ssosik/button-mash/docs/digikey-order-2026-09-30.csv

Index | Quantity | Part Number | Manufacturer Part Number | Description | Unit of Measure | Customer Reference | Available | Backorder | Unit Price | Extended Price USD
1 | 5 | 296-4655-5-ND | SN74AHCT125N | IC BUFF 4.5V/5.5V 14-PDIP |  | whack a mole | 5 | 0 | 0.95000 | $4.75
2 | 5 | AE9989-ND | A 14-LC-TT | CONN IC DIP SOCKET 14POS TIN |  | whack a mole | 5 | 0 | 0.56000 | $2.80
3 | 10 | CF14JT330RCT-ND | CF14JT330R | RES 330 OHM 5% 1/4W AXIAL |  | whack a mole | 10 | 0 | 0.02700 | $0.27
4 | 5 | 399-6637-ND | ESY108M016AH4AA | CAP ALUM 1000UF 20% 16V RADIAL |  | whack a mole | 5 | 0 | 0.96000 | $4.80
5 | 10 | 732-8793-1-ND | 860020372006 | CAP ALUM 100UF 20% 16V RADIAL TH |  | whack a mole | 10 | 0 | 0.12000 | $1.20
6 | 10 | 399-C315C104K5R5TA-ND | C315C104K5R5TA | CAP CER 0.1UF 50V X7R RADIAL |  | whack a mole | 10 | 0 | 0.48800 | $4.88
7 | 10 | 2946-221-415-ND | 221-415 | SPLICE LEVER 24-12AWG 5POS |  | whack a mole | 10 | 0 | 0.99100 | $9.91
8 | 1 | 243-1577-ND | 10189 | CRIMPER MIN INSULATED TERMINALS |  |  | 1 | 0 | 68.33000 | $68.33
9 | 50 | A27804CT-ND | 2-520181-2 | CONN QC RCPT 18-22AWG 0.187 |  | whack a mole | 50 | 0 | 0.22780 | $11.39
10 | 20 | 455-2218-ND | XHP-6 | CONN RCPT HSG 6POS 2.50MM |  | whack a mole | 20 | 0 | 0.08400 | $1.68
11 | 20 | 455-B6B-XH-A-ND | B6B-XH-A | CONN HEADER VERT 6POS 2.5MM |  | whack a mole | 20 | 0 | 0.19900 | $3.98
12 | 20 | 455-2266-ND | XHP-2 | CONN RCPT HSG 2POS 2.50MM |  | whack a mole | 20 | 0 | 0.05900 | $1.18
13 | 20 | 455-B2B-XH-A-ND | B2B-XH-A | CONN HEADER VERT 2POS 2.5MM |  | whack a mole | 20 | 0 | 0.08700 | $1.74
