ssosik/button-mash/docs/digikey-additions.csv

Quantity | Part Number | Manufacturer Part Number | Description | Customer Reference
70 | 455-1135TR-ND | SXH-001T-P0.6 | CONN SOCKET 22-28AWG CRIMP TIN | whack a mole
