ssosik/button-mash/hardware/whack a mole start button hole bushing.stl

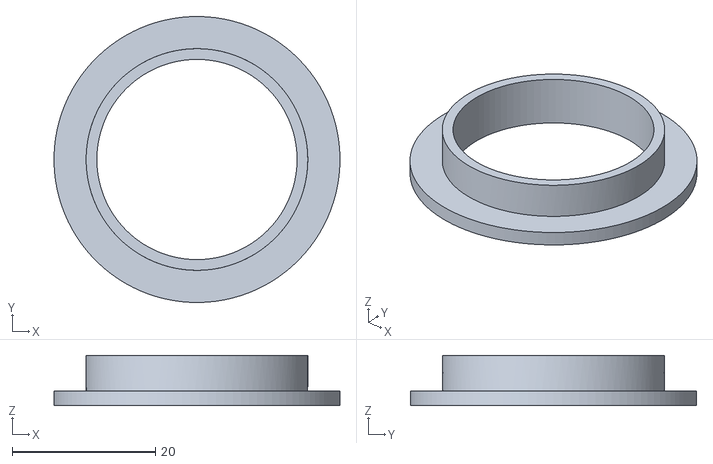
[picture p1: CAD file, 2026-10-30]
hardware/whack a mole start button hole bushing.stl
40.0 x 40.0 x 7.00
