ssosik/button-mash/hardware/whack a mole button hole bushing.stl

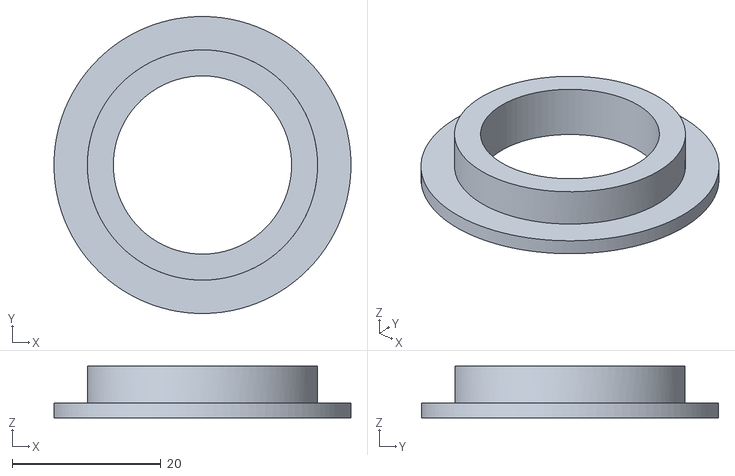
[picture p2: CAD file, 2026-10-30]
hardware/whack a mole button hole bushing.stl
40.0 x 40.0 x 7.00
