ssosik/button-mash/hardware/button-board/button-board.pdf

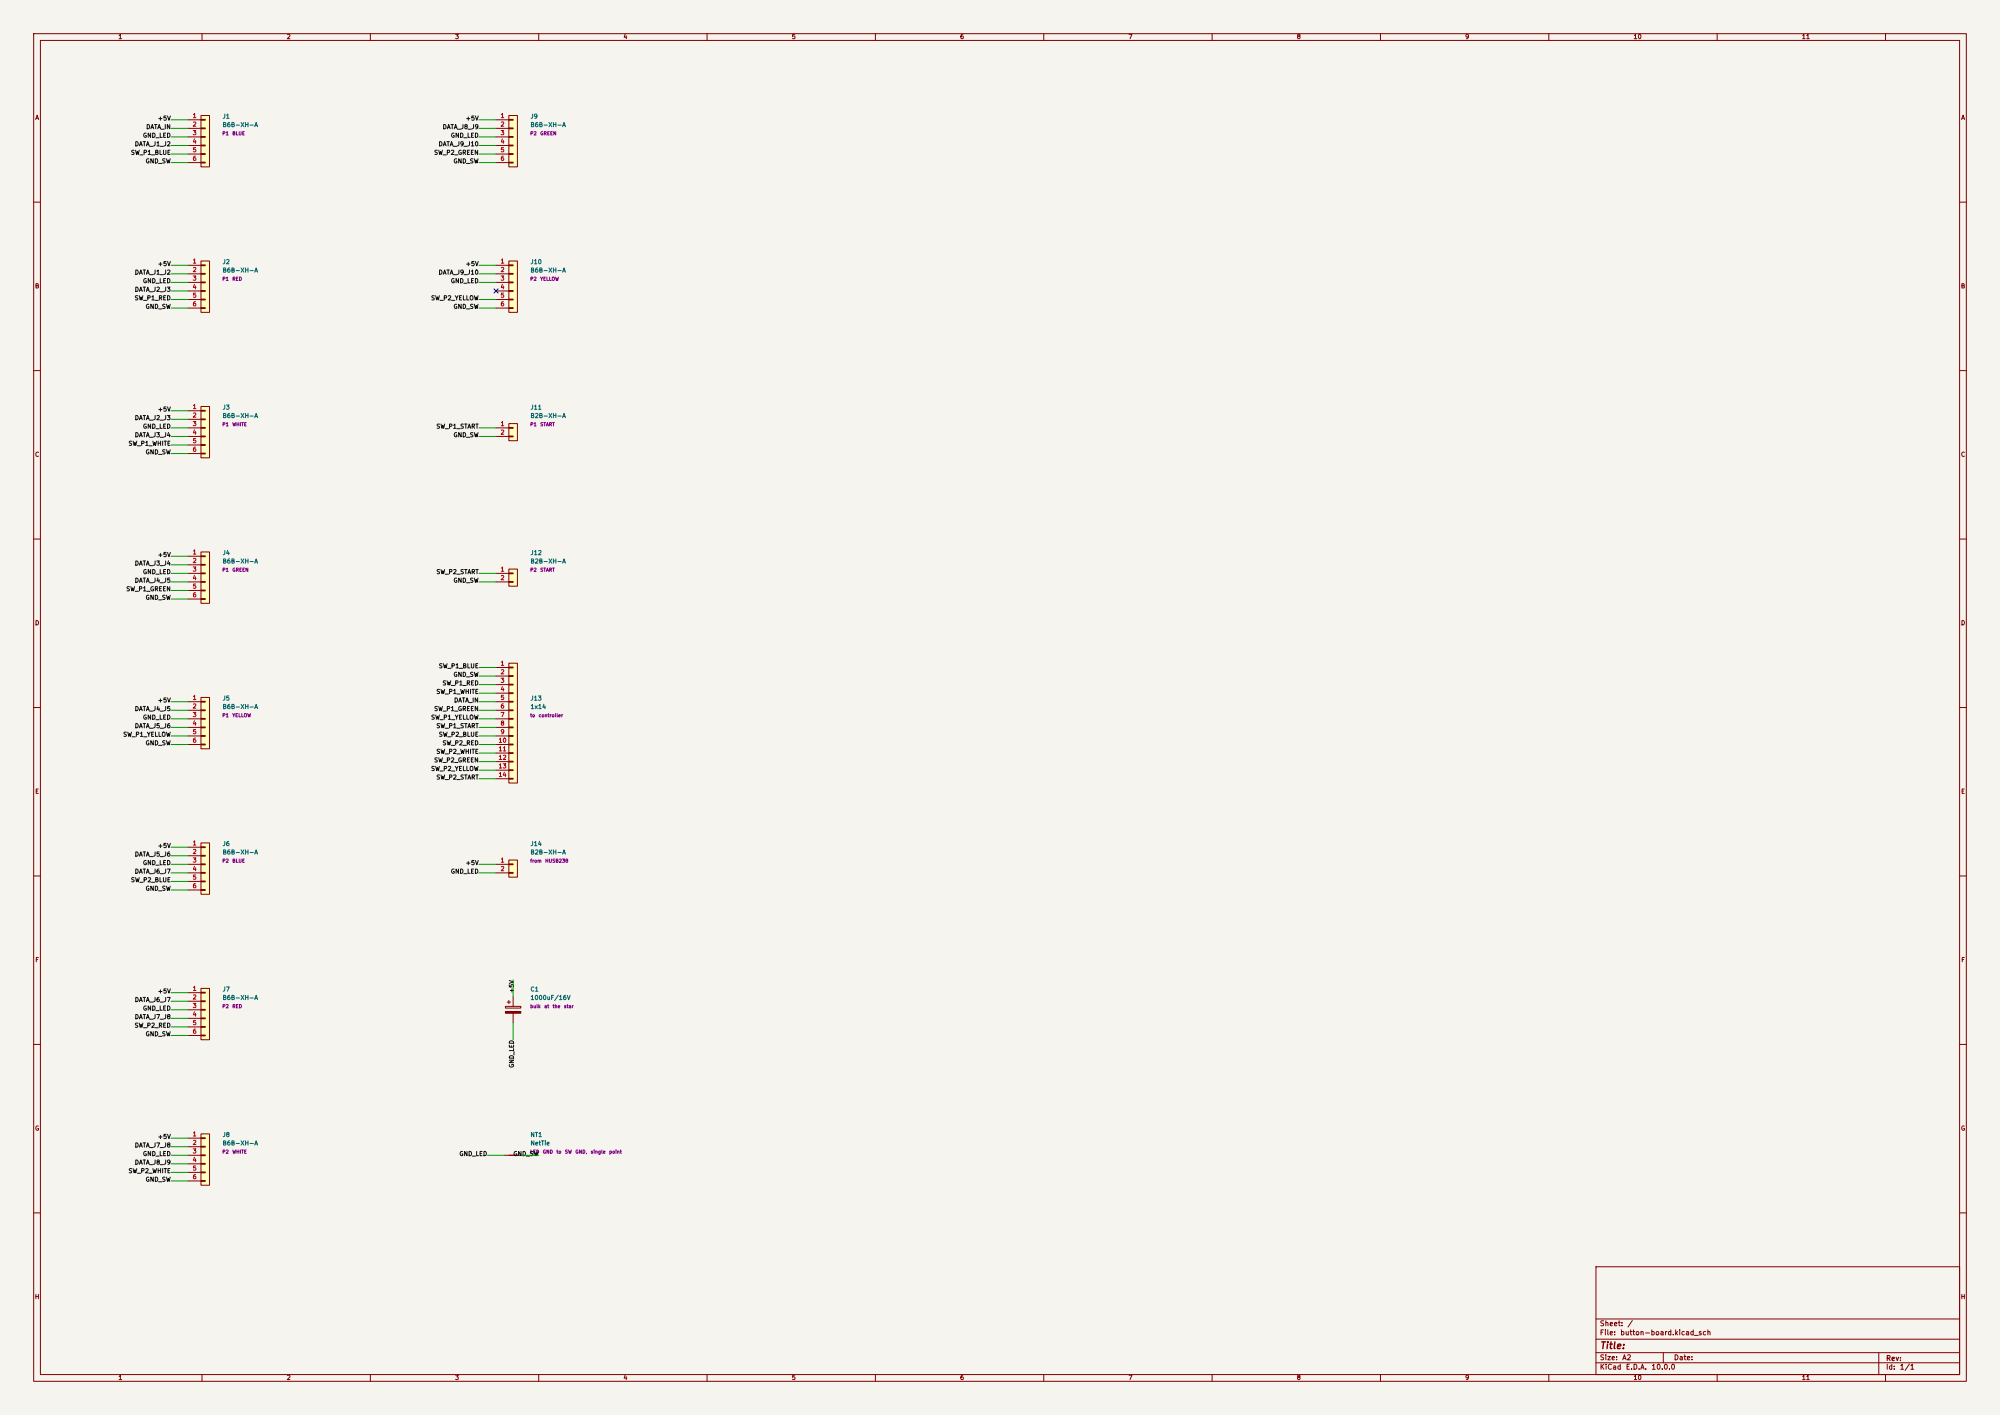
[picture p3: page 1]

LED GND to SW GND, single point 123456
P2 GREEN 12
SW_P2_GREEN

bulk at the star 123456
DATA_J3_J4 DATA_J5_J6 GND_LED

Size: A2 | Rev:
KiCad E.D.A. 10.0.0 | Id: 1/1
