ssosik/button-mash/hardware/controller-board/controller-board/controller-board.kicad_pcb

## KiCad design hardware/controller-board/controller-board/controller-board.kicad_pcb (2026-10-30)

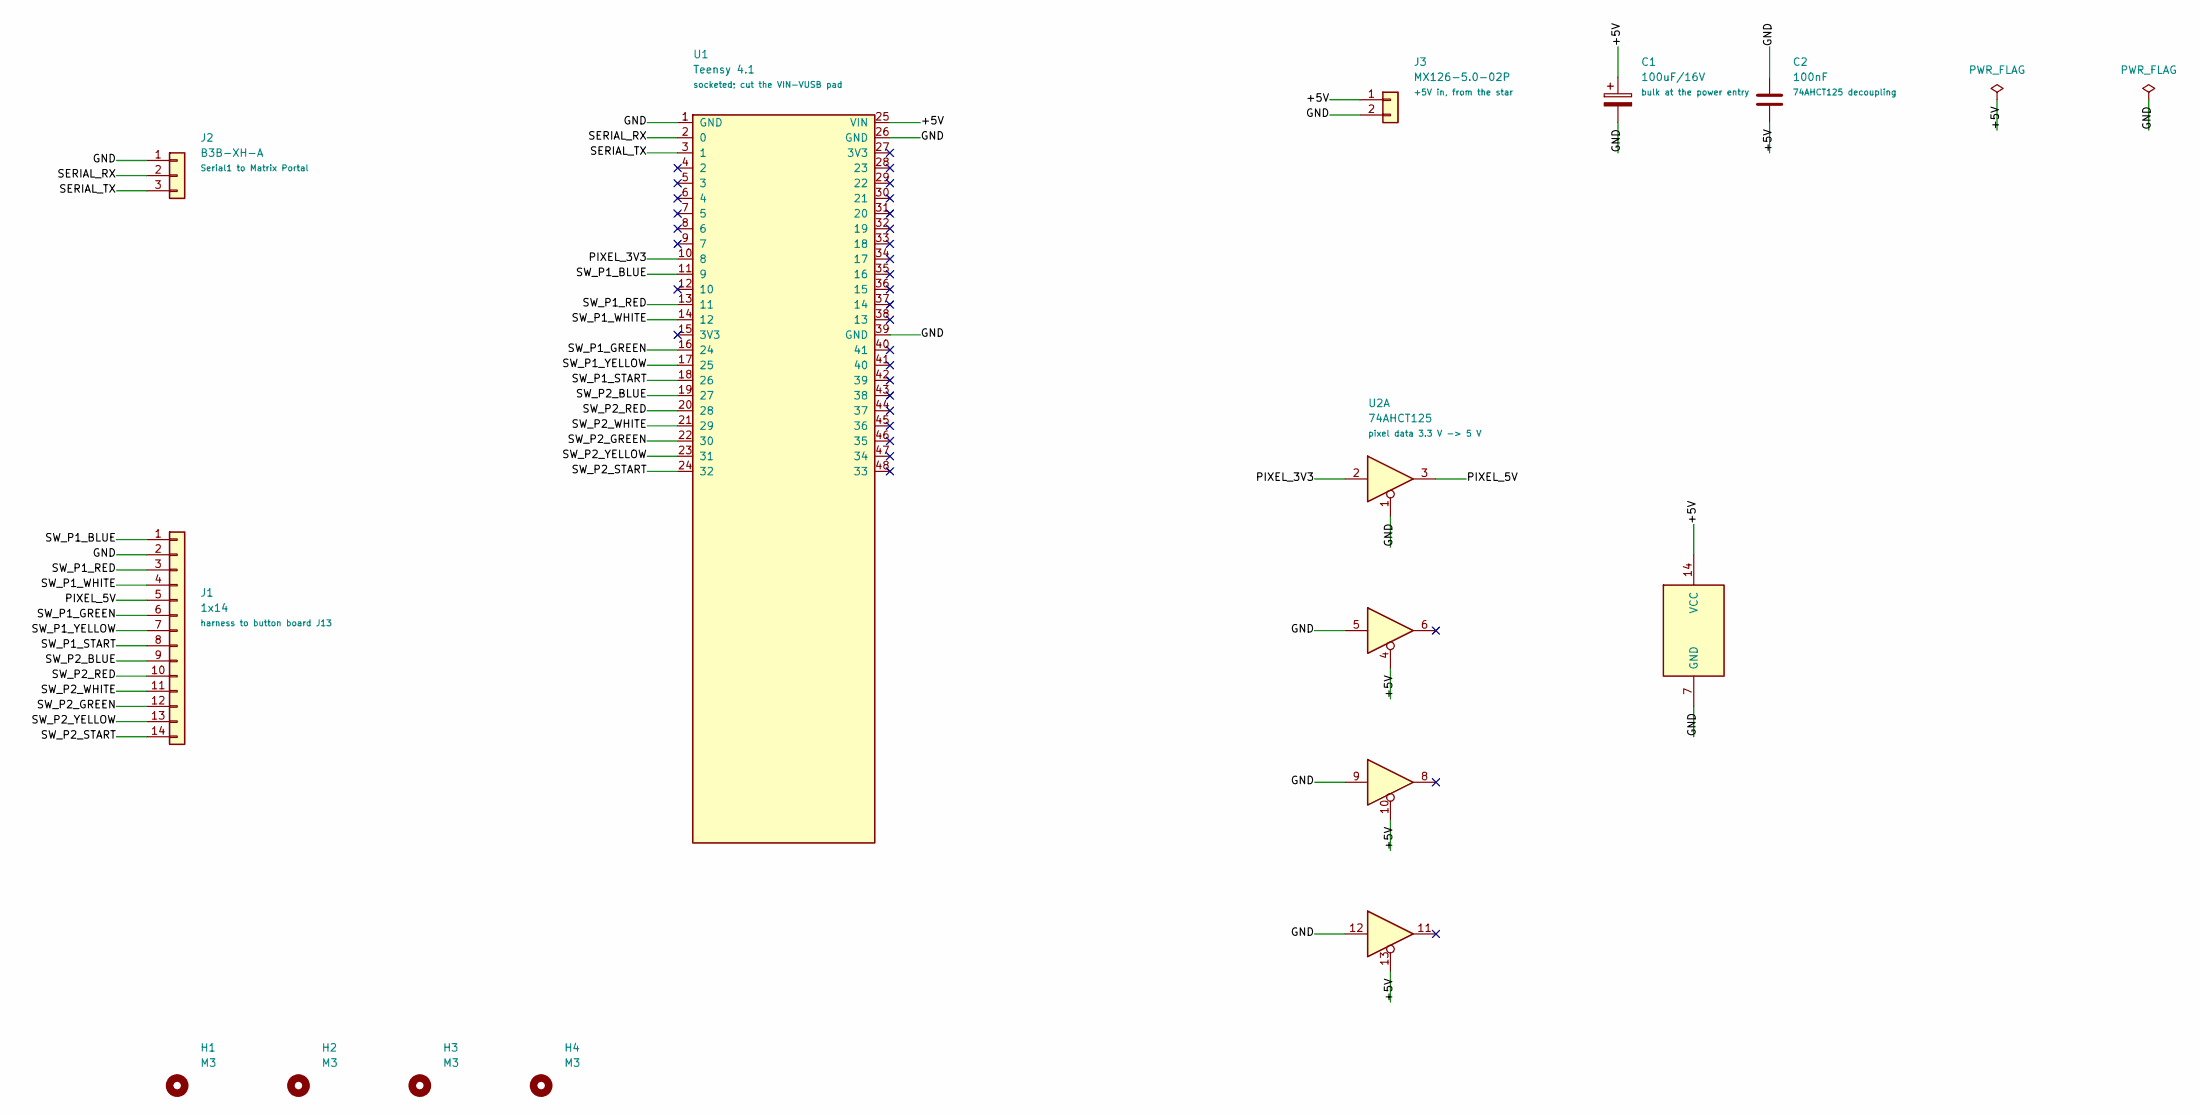
[picture p4: schematic controller-board.kicad_sch, Whack-A-Mole Attack - controller board]

Parts:
C1: 100uF/16V; CP_Radial_D6.3mm_P2.50mm
C2: 100nF; C_Disc_D5.0mm_W2.5mm_P5.00mm
H1, H2, H3, H4: M3; MountingHole_3.2mm_M3
J1: 1x14; PinHeader_1x14_P2.54mm_Vertical
J2: B3B-XH-A; JST_XH_B3B-XH-A_1x03_P2.50mm_Vertical
J3: MX126-5.0-02P; TerminalBlock_MaiXu_MX126-5.0-02P_1x02_P5.00mm
U1: Teensy 4.1; Teensy41_Socketed
U2: 74AHCT125; DIP-14_W7.62mm_Socket

Connections:
/+5V: C1.1, C2.2, J3.1, U1.25 (VIN), U2.4, U2.10, U2.13, U2.14 (VCC)
/GND: C1.2, C2.1, J1.2, J2.1, J3.2, U1.1 (GND), U1.26 (GND), U1.39 (GND), U2.1, U2.5, U2.7 (GND), U2.9, U2.12
/PIXEL_3V3: U1.10 (8), U2.2
/PIXEL_5V: J1.5, U2.3
/SERIAL_RX: J2.2, U1.2 (0)
/SERIAL_TX: J2.3, U1.3 (1)
/SW_P1_BLUE: J1.1, U1.11 (9)
/SW_P1_GREEN: J1.6, U1.16 (24)
/SW_P1_RED: J1.3, U1.13 (11)
/SW_P1_START: J1.8, U1.18 (26)
/SW_P1_WHITE: J1.4, U1.14 (12)
/SW_P1_YELLOW: J1.7, U1.17 (25)
/SW_P2_BLUE: J1.9, U1.19 (27)
/SW_P2_GREEN: J1.12, U1.22 (30)
/SW_P2_RED: J1.10, U1.20 (28)
/SW_P2_START: J1.14, U1.24 (32)
/SW_P2_WHITE: J1.11, U1.21 (29)
/SW_P2_YELLOW: J1.13, U1.23 (31)

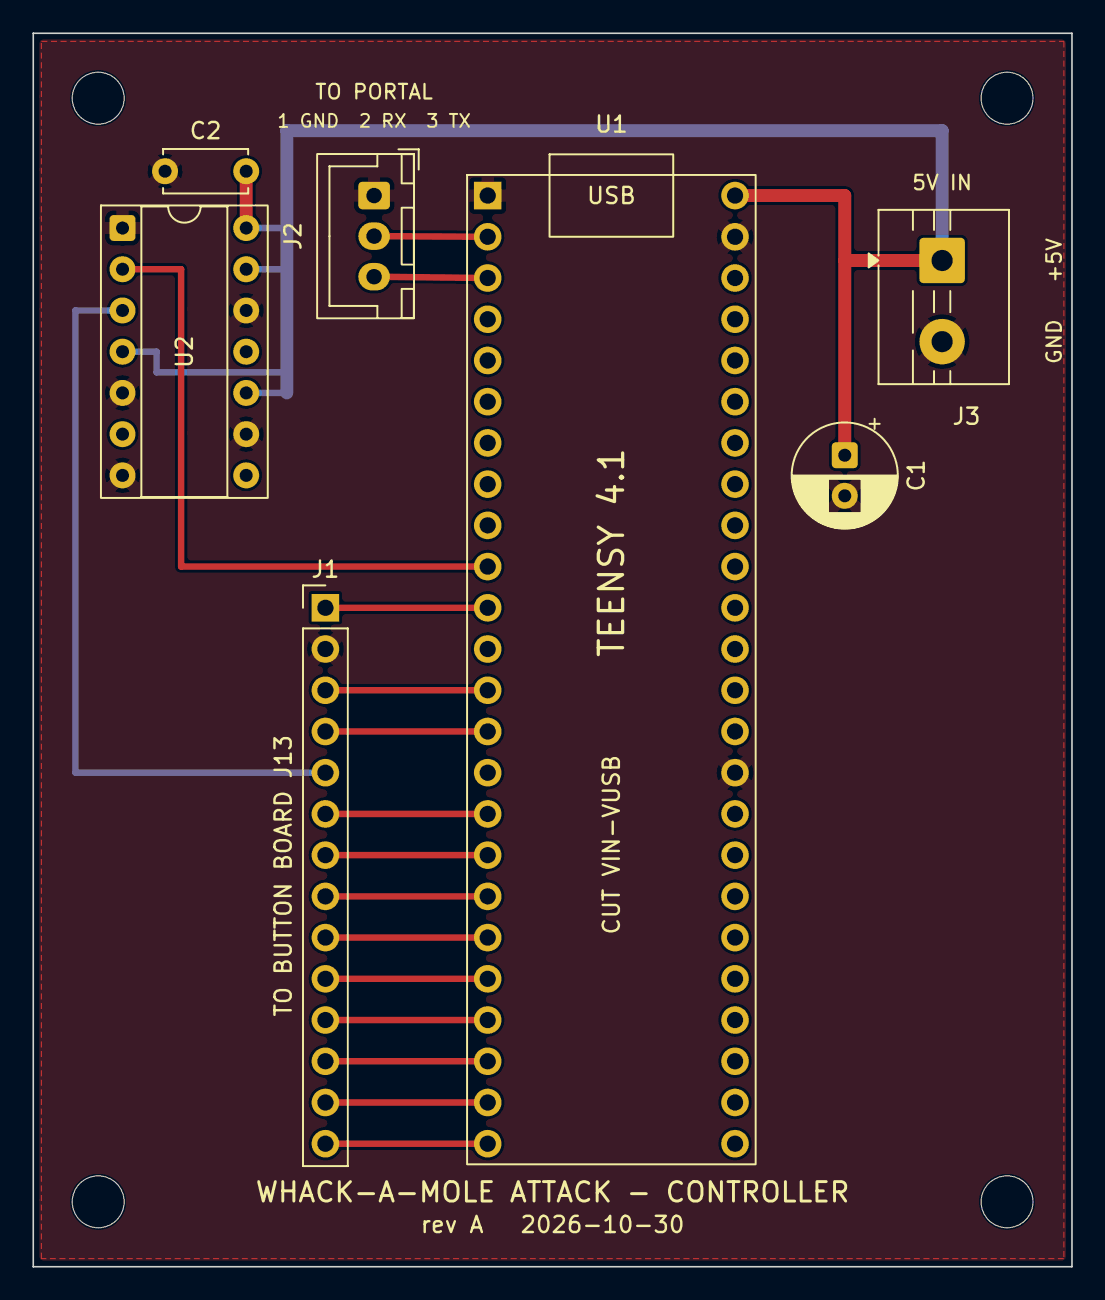
[picture p5: board controller-board.kicad_pcb from above]

Board: 2 copper layers, 64.0 x 76.0 mm, 11 parts (0 on the bottom side), 18 nets.
