ssosik/button-mash/hardware/button-board/button-board/button-board.kicad_pcb

## KiCad design hardware/button-board/button-board/button-board.kicad_pcb (2026-10-30)

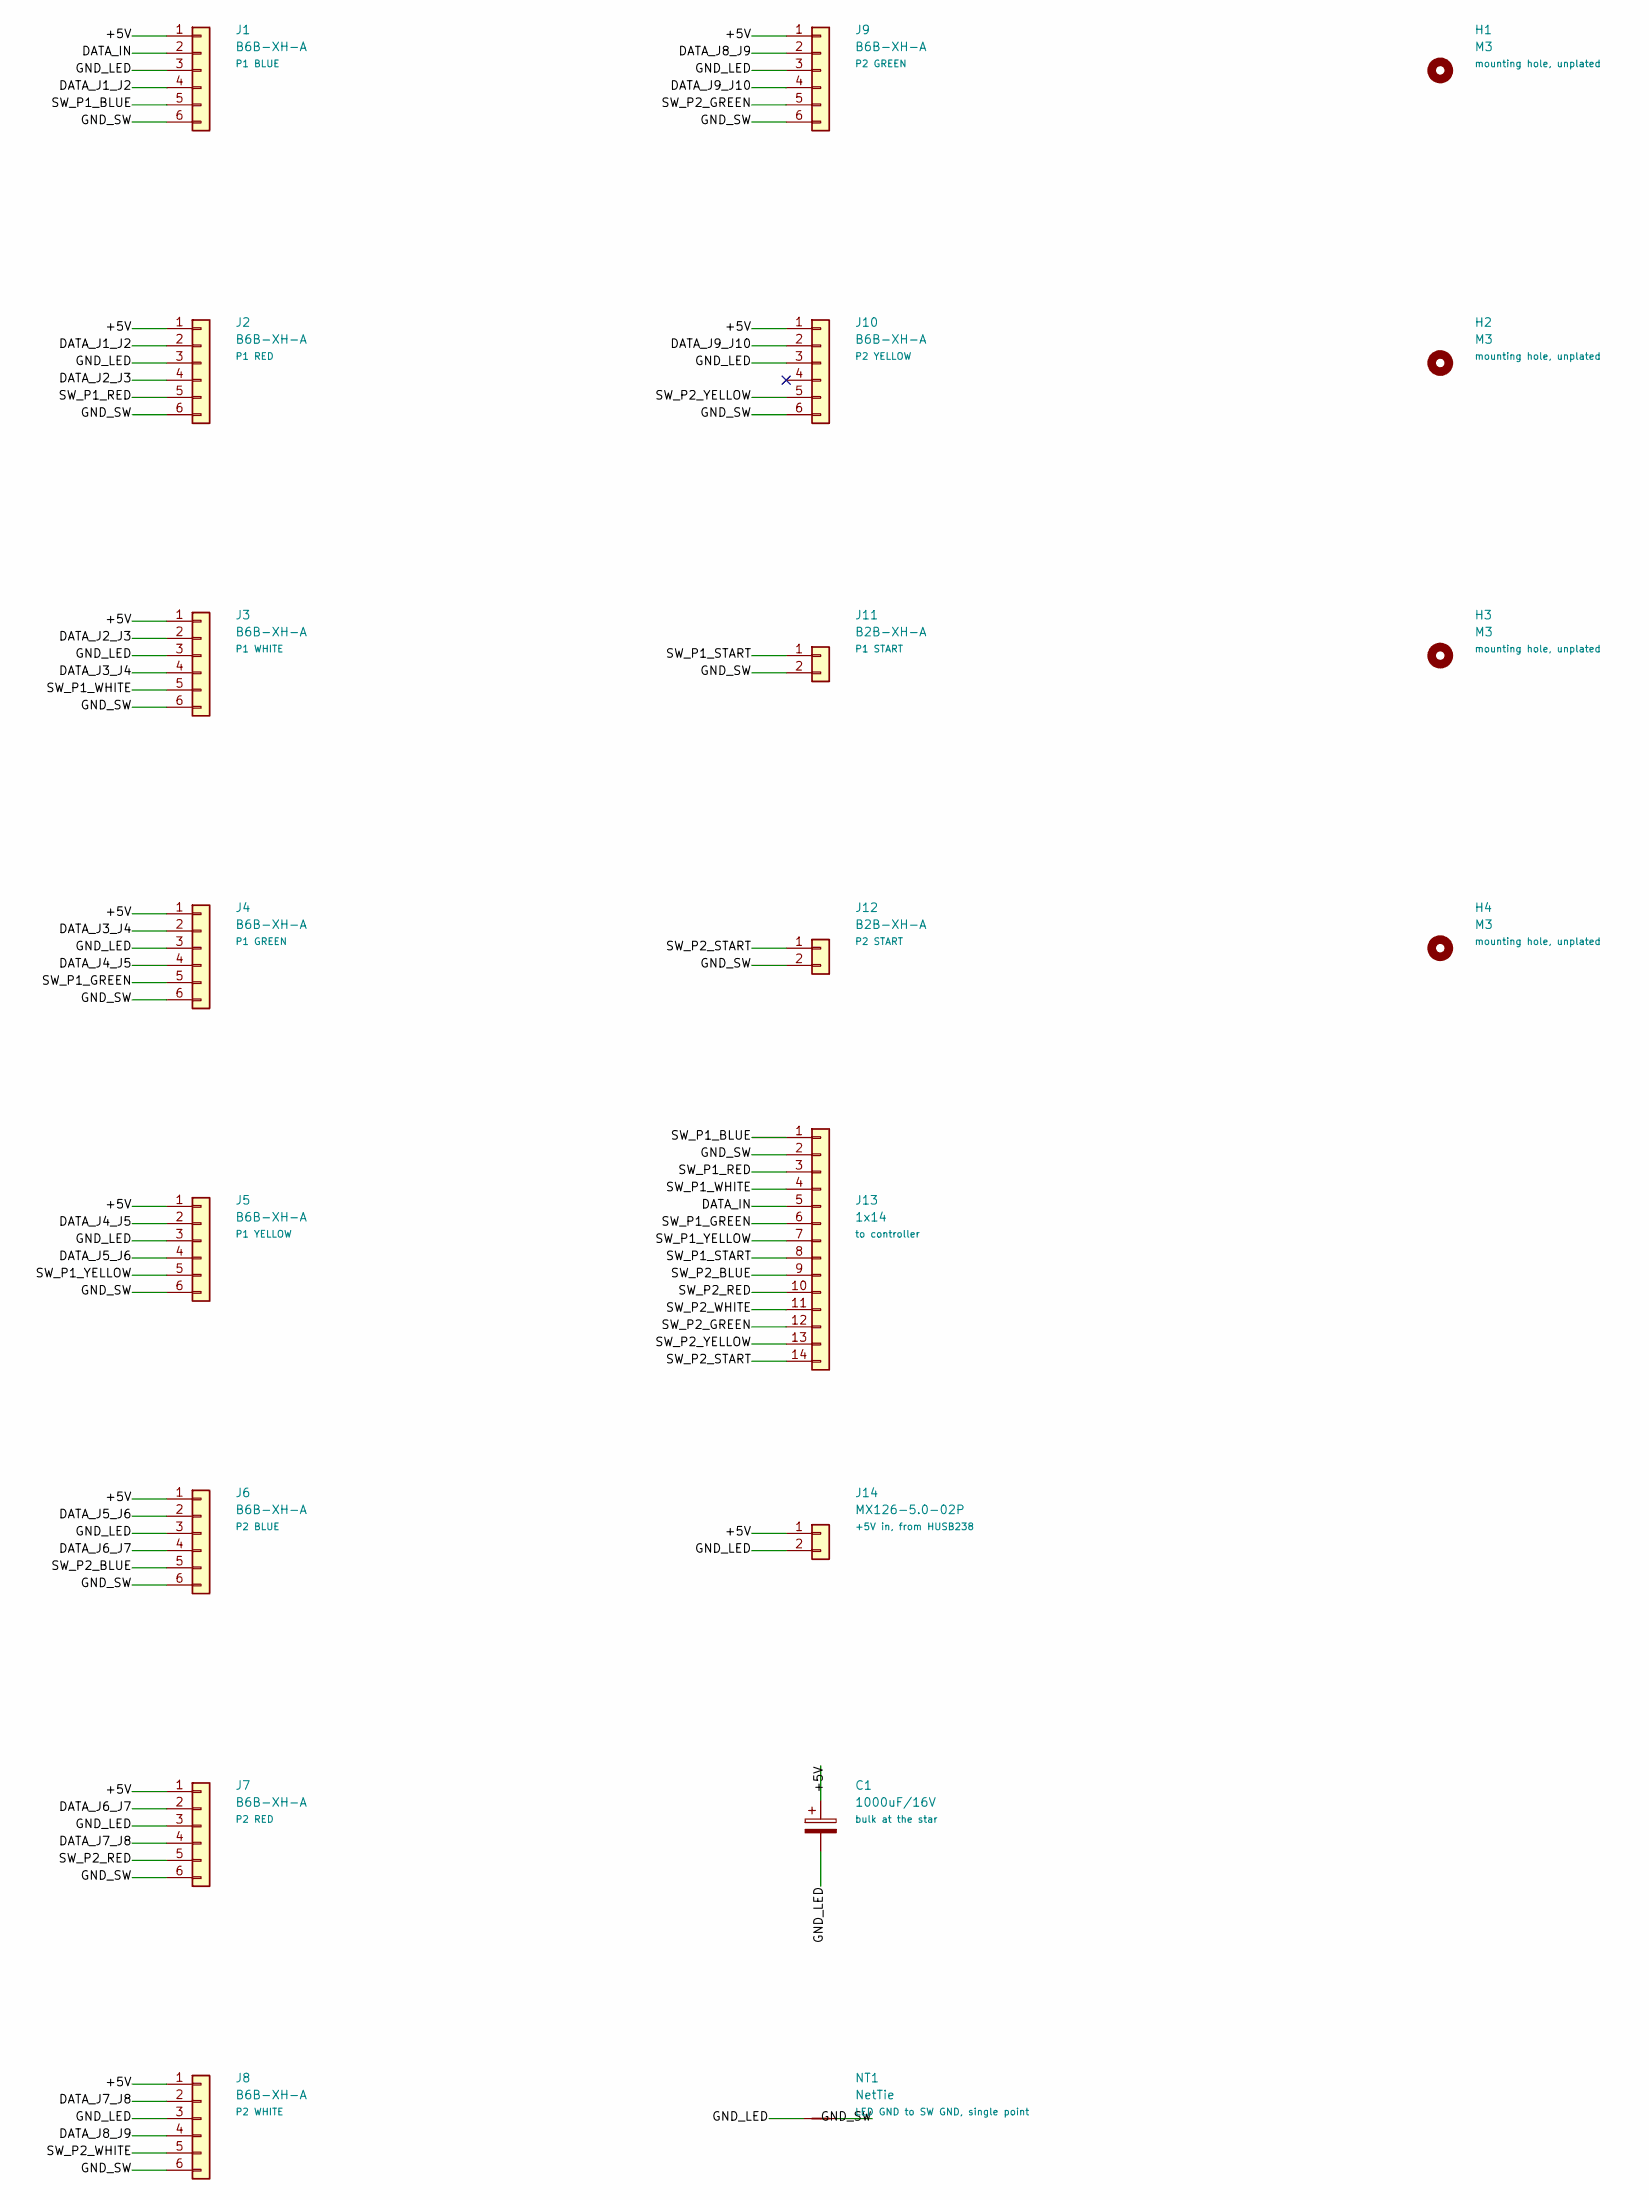
[picture p6: schematic button-board.kicad_sch]

Parts:
C1: 1000uF/16V; CP_Radial_D10.0mm_P5.00mm
H1, H2, H3, H4: M3; MountingHole_3.2mm_M3
J1, J2, J3, J4, J5, J6, J7, J8, J9, J10: B6B-XH-A; JST_XH_B6B-XH-A_1x06_P2.50mm_Vertical
J11, J12: B2B-XH-A; JST_XH_B2B-XH-A_1x02_P2.50mm_Vertical
J13: 1x14; JST_XH_B14B-XH-A_1x14_P2.50mm_Vertical
J14: MX126-5.0-02P; TerminalBlock_MaiXu_MX126-5.0-02P_1x02_P5.00mm
NT1: NetTie; NetTie-2_THT_Pad1.0mm

Connections:
/+5V: C1.1, J1.1, J2.1, J3.1, J4.1, J5.1, J6.1, J7.1, J8.1, J9.1, J10.1, J14.1
/DATA_IN: J1.2, J13.5
/DATA_J1_J2: J1.4, J2.2
/DATA_J2_J3: J2.4, J3.2
/DATA_J3_J4: J3.4, J4.2
/DATA_J4_J5: J4.4, J5.2
/DATA_J5_J6: J5.4, J6.2
/DATA_J6_J7: J6.4, J7.2
/DATA_J7_J8: J7.4, J8.2
/DATA_J8_J9: J8.4, J9.2
/DATA_J9_J10: J9.4, J10.2
/GND_LED: C1.2, J1.3, J2.3, J3.3, J4.3, J5.3, J6.3, J7.3, J8.3, J9.3, J10.3, J14.2, NT1.1
/GND_SW: J1.6, J2.6, J3.6, J4.6, J5.6, J6.6, J7.6, J8.6, J9.6, J10.6, J11.2, J12.2, J13.2, NT1.2
/SW_P1_BLUE: J1.5, J13.1
/SW_P1_GREEN: J4.5, J13.6
/SW_P1_RED: J2.5, J13.3
/SW_P1_START: J11.1, J13.8
/SW_P1_WHITE: J3.5, J13.4
/SW_P1_YELLOW: J5.5, J13.7
/SW_P2_BLUE: J6.5, J13.9
/SW_P2_GREEN: J9.5, J13.12
/SW_P2_RED: J7.5, J13.10
/SW_P2_START: J12.1, J13.14
/SW_P2_WHITE: J8.5, J13.11
/SW_P2_YELLOW: J10.5, J13.13

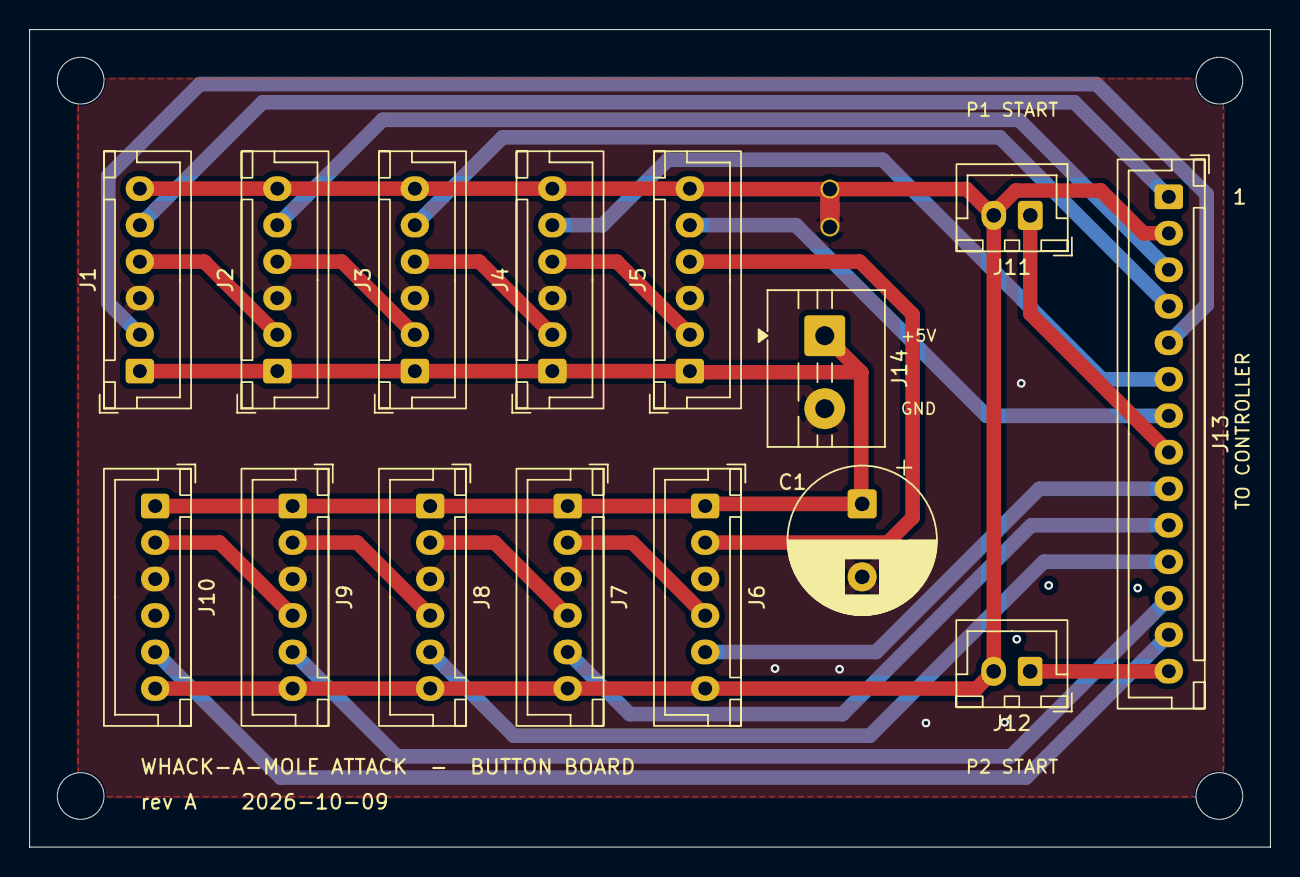
[picture p7: board button-board.kicad_pcb from above]

Board: 2 copper layers, 85.0 x 56.0 mm, 20 parts (0 on the bottom side), 25 nets.
