ssosik/button-mash/(commit log)

2026-10-17 Add a host-side panel test that keeps the panel and the terminal in step
    Debugging the LED panel by hand has a long feedback loop: drive a pattern, look
    up, try to remember which step it was, report back. This drives the panel from
    the host over the CircuitPython REPL and names each pattern before waiting for
    you, so the panel and the screen cannot drift apart. Every step also states what
    it should look like and what a deviation means.
    Pattern order is the diagnostic argument: whether the panel blanks on command at
    all, then which colour channels light at a current too low for the supply to
    matter, then the same at full current, then geometry. That separates a dead data
    line from a sagging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
2026-10-17 Record what a panel fed through the Portal actually looks like
    The rule to feed the panel from the bus rather than through the Matrix Portal
    was already there; what it does not say is how you find out you broke it. Wiring
    the panel to the Portal's screw terminals lit it red and only red, at every
    colour commanded and every brightness, with banding that crawled as the scan
    ran. Red dice forward at about 1.8 V against nearer 3.0 V for green and blue, so
    a rail pulled down by the path through the Portal's USB-C connector and traces
    still lights red and nothing else.
    Writes down the discriminator too, because I got it backwards in the moment and
    it cost a detour: "always red, even dim" is not e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
2026-10-17 Make the debug combo reachable from attract mode
    Holding both start buttons started a game instead of entering debug. TakePress
    latches on the press edge and fires on the next tick, while the debug combo
    needs both buttons held for two seconds, so HandleAttractInput checked the
    combo, got false, then immediately consumed P1's start press and left attract
    mode. The gesture could never complete: the combo was unreachable from attract
    mode entirely.
    It looked like a regression because the display started working. DebugComboHeld
    is also checked in DisplayReadyWait, where nothing competes for the press, so
    while the Matrix Portal was silent the Teensy sat in that state re-announcing
    CONREADY and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
2026-10-17 Let either player's lamps flush the shared pixel chain
    PixelLights::Show() returned early unless the instance owned the chain, which
    only P1's does. So P2's lamp changes reached the caps only the next time P1
    happened to call Show(): up to a blink period late in a two-player game, and
    never at all in a P2-only game, where P1 is not ready, its Update() returns
    early, and nothing ever calls P1's Show().
    Unseen so far because the only cap on the bench is P1 BLUE. The game modes
    step lamps far faster than a 200 ms blink, so it would have been obvious.
    Set() now marks a shared dirty flag and either instance's Show() flushes when
    it is set. One chain carries both players, so one flag is enough,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
2026-10-17 Bring panel-test.py in line with the project's ruff config
    It failed ruff check on 28 counts when it went in: percent formatting where
    ruff.toml asks for f-strings, and one try/except/pass that wants
    contextlib.suppress. Fixed, and formatted.
    No behaviour change. Every pattern's board commands and expected-result text
    are byte-identical to before, and the protocol test against the fake REPL --
    swallowed first character, paste mode, line order -- still passes.
2026-10-17 Play a medley of five modes instead of one mole game
    A game now runs every mode in MODE_LIST in turn, both players at once, each for
    its own segment with a banner between them; score carries across and the higher
    total wins.
    Whack the original game 12 s
    Captcha find the cap showing the colour your score is drawn in 15 s
    Chase hit the runner as it circles; speeds up as you do 12 s
    Logic step every cap to the target colour 20 s
    Simon watch the sequence, play it back 20 s
    The mole game was welded into Player, so it comes out into a Mode interface:
    Begin, Update, and an optional target col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
2026-10-23 Flash "CUB SCOUT BUTTON MASH" as the title, one word at a time
    The power-on title used to scroll "Whack A Mole Attack". It now shows
    each word on its own, in capitals, in both players' columns, and loops
    until the Teensy first sends something.
    terminalio fits five letters in a 32-pixel column and BUTTON has six,
    so the title uses its own 7-row font that covers only the letters it
    needs. Each column is turned the same way as its player's score.
2026-10-23 Show the held button as a still "P1 B3" in debug mode
    The BUTTONS screen used to scroll the colour name, as in "P1 GREEN". It
    now sends the player and the button's position in wiring order, B1-B5,
    or ST for start. The display shows any #DEBUG banner of five characters
    or fewer still, the way it shows mode banners, and scrolls anything
    longer. Serial output still names the colours.
2026-10-23 Light every cap at power-on and make the caps dance on the splash
    A USB power bank switches its output off when the load looks idle. The
    caps now light white as soon as the Teensy boots and stay lit until
    NewGame clears them for the attract loop. Nothing else draws much while
    the display is still coming up.
    During the splash screen the caps run a dance (Dance.cpp): colours
    spinning round each ring in kChasePath order, all caps flashing, then
    alternate caps swapping, with P2's ring spinning the opposite way to
    P1's. It is a pure function of time since the splash began, so there is
    no state to reset. The lamps clear whenever the splash hands off.
    make test covers the dance: only its own colo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
2026-10-23 Replace the mole splash with a spinning pinwheel behind the title
    The splash no longer scrolls the running-mole bitmap. It shows a
    twelve-blade rainbow pinwheel across the whole panel, with the title
    flashing CUB SCOUT BUTTON MASH a word at a time on top. The power-on
    title is now this same scene, so there is one look throughout.
    Each pixel belongs to one blade for good, and the pinwheel spins by
    rotating the palette, which costs twelve palette writes per step rather
    than a redraw of 1,024 pixels. The blades are dimmed and every letter
    has a one-pixel black outline, so the words stay legible over any
    colour.
    The bitmap file is gone, and the README copy step drops it.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
2026-10-30 Get CI green: format to clang-format 18, fix ruff findings, run the tests
    CI has failed on this branch since early October, on formatting and
    Python lint. Nothing in this commit changes behaviour:
    - Every C++ source and the tests are formatted with clang-format 18.1.8,
    the version the runner installs. clang-format 23 agrees with it.
    - Python is ruff-clean across the repo, not just display/, because the
    ruff action checks everything. The fixes are a context-managed open,
    a renamed `l`, one wrapped line and ruff format. gen-netlist.py and
    gen-schematic.py produce byte-identical output (UUIDs masked).
    - make lint-py now covers the same files as CI. CLANG_FORMAT and RUFF
    can be overri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
2026-10-30 Bring the README up to the rebuilt table, and add CLAUDE.md
    The README described version 1 in several places:
    - The power section named a CH224K; the table uses an HUSB238.
    - The pin map listed pins that no longer exist. It now gives the
    current table and version 1 side by side, as Config.h does.
    - "Circuit schematic: TODO" now links the wiring reference and the
    button board.
    - The layout block omits docs/, firmware/test/ and the PCB.
    - The 330 Ω resistor sat at the first pixel; it is now in every cap.
    - It never said the current table needs `GPIO=1 PIXELS=1`.
    The retrospective sections are kept as written, under a "Version 1
    retrospective" heading, with a note on what version 2 chang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
2026-10-30 Default the build to the rebuilt table
    Config.h and the Makefile now default to WAM_INPUT_GPIO=1 and
    WAM_LIGHTS_PIXELS=1, the hardware the table actually has. A bare `make
    upload` used to flash version 1's resistor-ladder build onto it.
    Version 1 is still one override away (`make upload GPIO=0 PIXELS=0`),
    and CI still compiles all four combinations.
2026-10-30 Add a system overview diagram
    One picture of the whole table: the power bank, the HUSB238 and the
    star point feeding the four loads, with each drop's gauge and current.
    It also shows the Teensy's Serial1 link to the Matrix Portal, the
    14-way harness to the button board, and the pigtails out to the caps
    and start buttons. The LED panel's own feed from the star is drawn
    explicitly, since powering it through the Portal is what turned the
    panel red.
    Embedded at the top of the README's Circuit section. Currents and pins
    come from the wiring reference and Config.h.
2026-10-30 Add a 3D render of the button board to the README
    Rendered with kicad-cli from the board file; `make board-render`
    regenerates it.
    KiCad 10's footprint for the J14 MX126 terminal block names a 3D model
    that the library does not ship, so it rendered as bare pads. The board
    now points J14 at the Phoenix MKDS 1,5 2-pole model instead: same 5 mm
    pitch, near-identical body, and it sits inside the footprint outline.
    This is a 3D-view-only change; pads, copper and fab outputs are
    untouched.
2026-10-30 Correct the stale chain-order table, and make check-pins cover it
    The wiring reference's "Chain order must match Config.h" table still
    listed version 1's switch pins (2, 3, 4, 5, 9 / 11, 12, 14, 15, 16 /
    22 and 25). check-pins never read that table, so the remap went past
    it unnoticed. It now matches Config.h: 9, 11, 12, 24, 25 / 27-31 /
    26 and 32.
    check-pins now checks the table as well. Putting the old values back
    fails it.
2026-10-30 Add a generated schematic and PCB for the controller board
    hardware/controller-board/ makes the controller stripboard as a
    two-layer PCB. It uses the same parts and the same pinout as the
    stripboard, so the existing harness, serial cable and power lead plug
    in unchanged. Nothing in it is drawn by hand:
    - gen-netlist.py takes the harness positions from the button board's
    generator and the switch pins from Config.h, so all three agree by
    construction. Its validator rejects a pin on two nets, a pin on
    none, a net with one end, or a disabled '125 output wired to
    anything, each tested by injecting the fault.
    - gen-schematic.py draws the schematic with net-label stubs, like the
    button b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
